martc55/Jbd2Solis/Image_Schematic.jpg

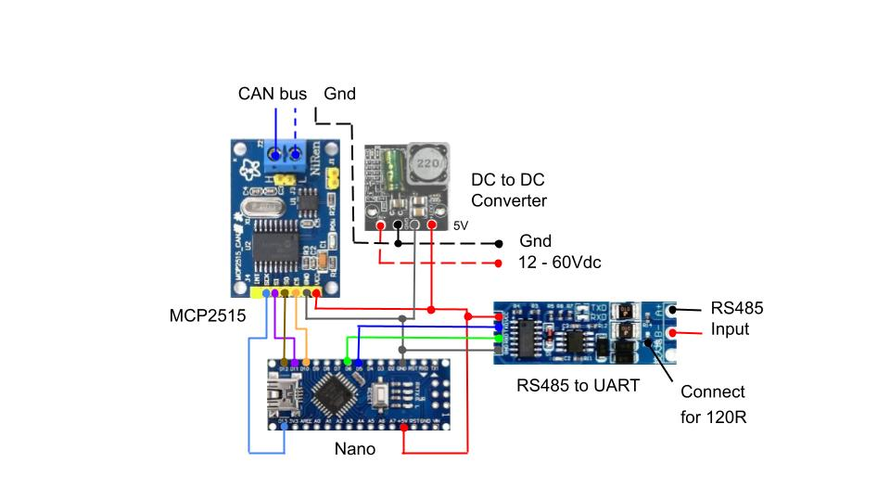
Image_Schematic.jpg
