martc55/Jbd2Solis/Image_Project.jpg

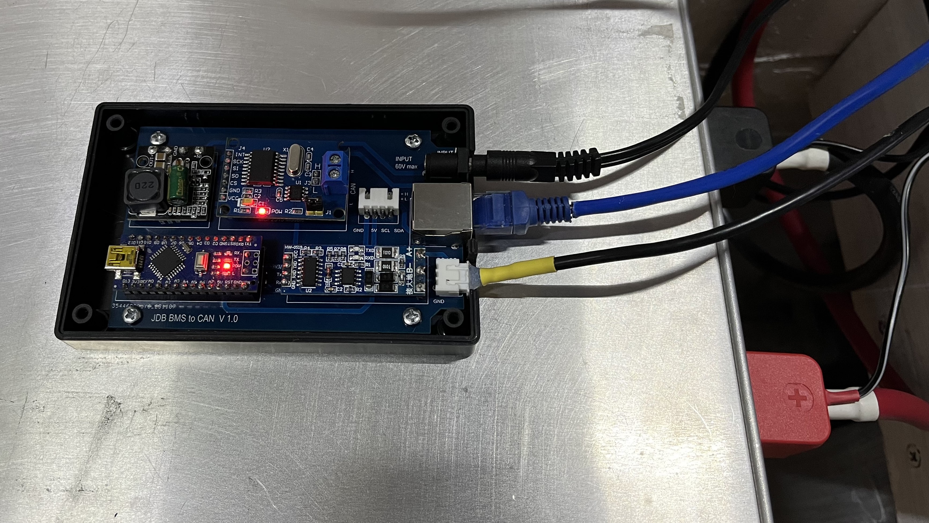
Image_Project.jpg
