martc55/Jbd2Solis/Image_CAN.jpg

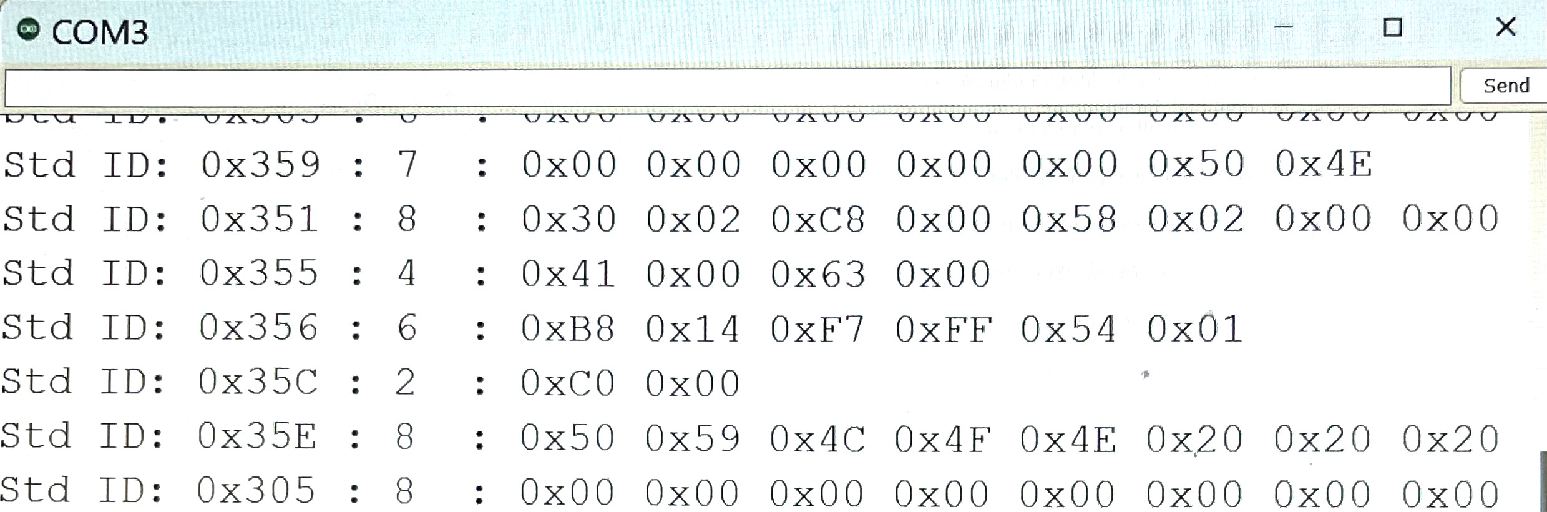
Image_CAN.jpg
