martc55/Jbd2Solis/Image_Info.jpg

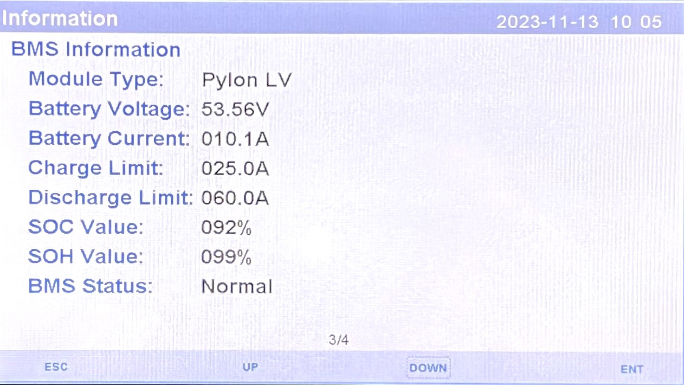
Image_Info.jpg
